Mason270901/vertical-profiling-float/pictures/scope/README.md

1: yellow trace is the 47k + 100nF pulled up signal. green is the esp32's idea of every edge
2: same as 1, but zoomed out
