Mason270901/vertical-profiling-float/datasheets/linear_actuator.jpg

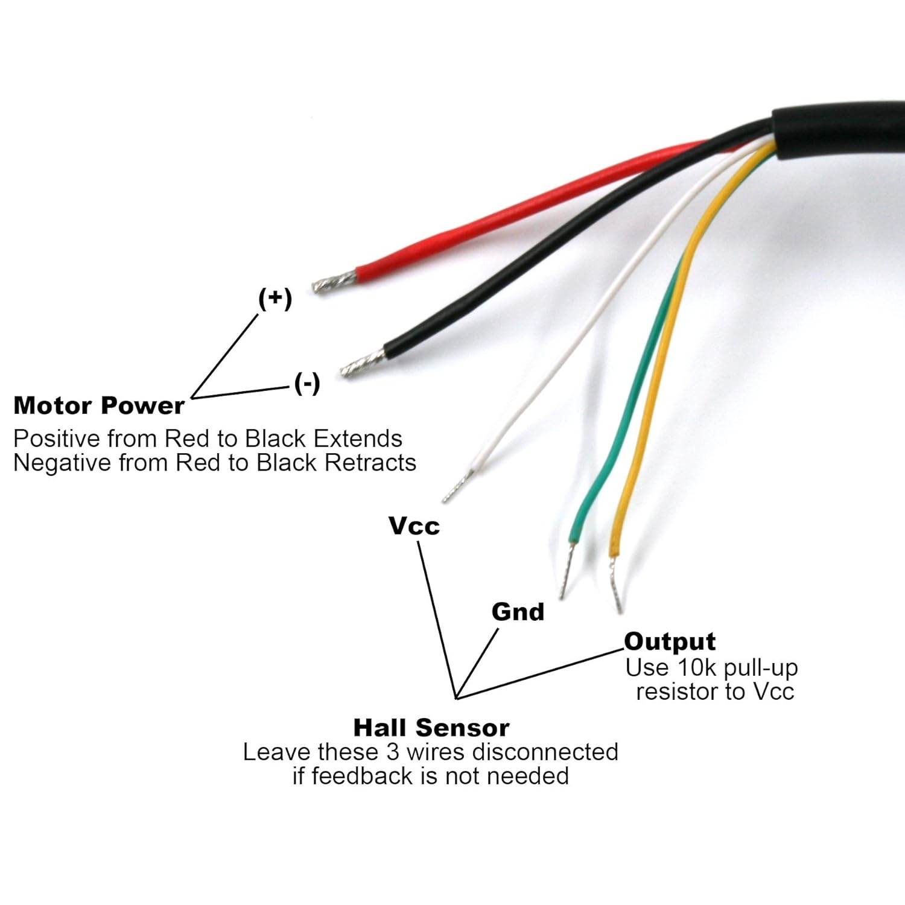
datasheets/linear_actuator.jpg
