Mason270901/vertical-profiling-float/datasheets/linear_actuator_schematic.jpg

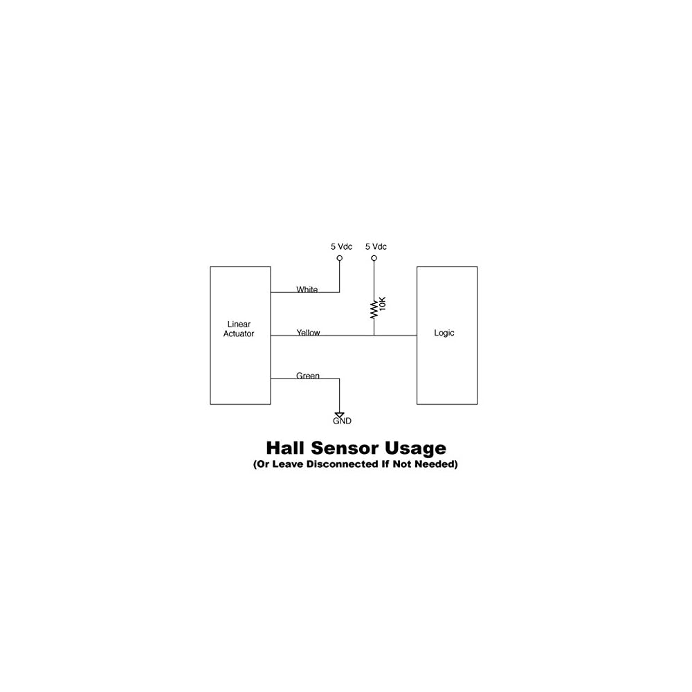
datasheets/linear_actuator_schematic.jpg
