Mason270901/vertical-profiling-float/pictures/scope/scope_1.png

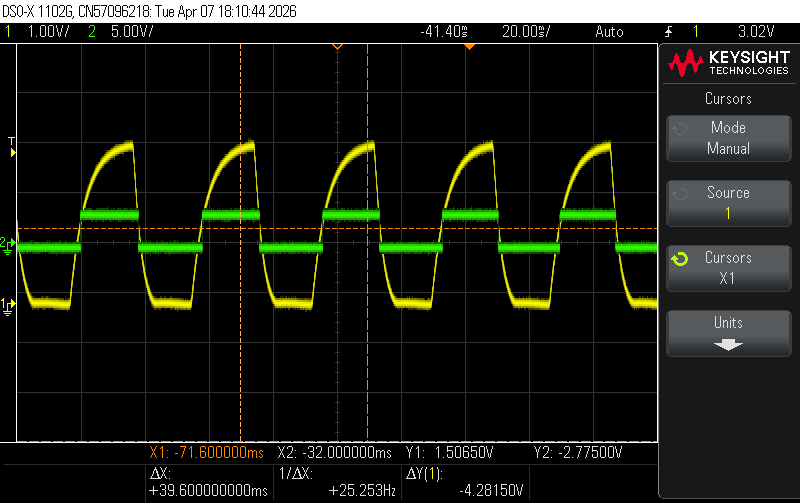
pictures/scope/scope_1.png
