Mason270901/vertical-profiling-float/pictures/scope/scope_2.png

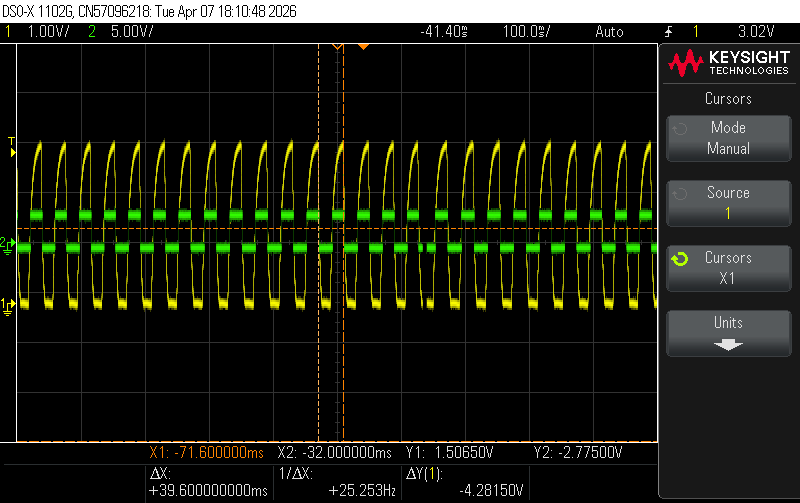
pictures/scope/scope_2.png
