Mason270901/vertical-profiling-float/wireviz/vert.png

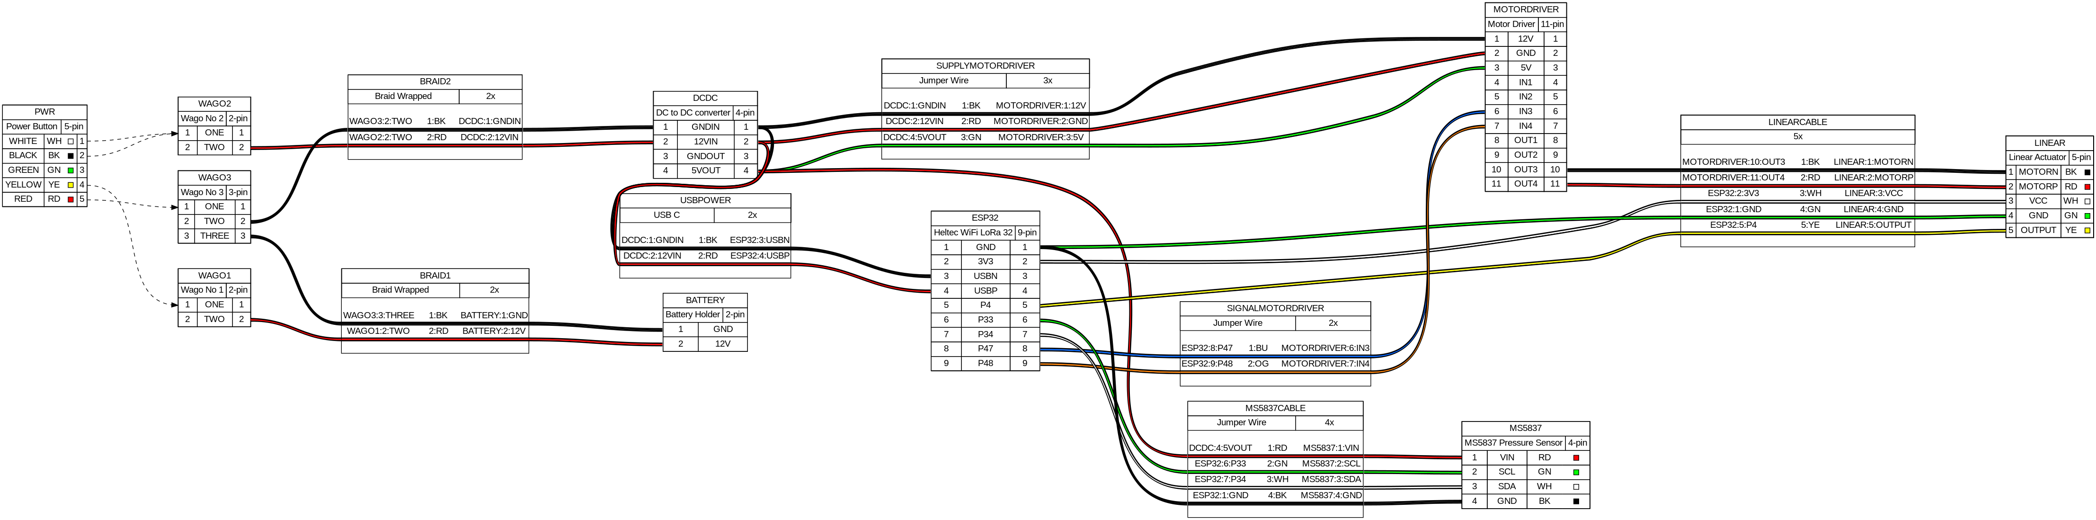
wireviz/vert.png
