Mason270901/vertical-profiling-float/varduino/varduino.ino

/*
  Vertical Profiling Float — web server with AJAX endpoints.
  Files are served from a LittleFS image flashed to the spiffs partition.

  Steps:
  1. Put files in varduino/data/
  2. Run: make fs-flash   (builds and flashes the LittleFS image)
  3. Run: make && make program  (compile and flash the sketch)
  4. Connect to the access point "yourAP"
  5. Browse to http://192.168.4.1/

  AJAX endpoints (return JSON, no redirect):
    GET /H     — turn LED on  → {"led":"on"}
    GET /L     — turn LED off → {"led":"off"}
    GET /data  — [[depth,pressure],...] array → {"data":[[...],...]}
*/

// for wifi
#include <WiFi.h>
#include <WiFiAP.h>
#include <LittleFS.h>
// for pressure
#include <Wire.h>
#include "MS5837.h"
// my lib for syringe
#include "syringe.hpp"

///////////////////////////////////////////////////////////////////////////////
// Pressure Sensor
// Red   - Vin   (5V)
// Green - SCL   (CLOCK)
// White - SDA   (DATA)
// Black - GND
#define CLOCK 33
#define DATA  34

///////////////////////////////////////////////////////////////////////////////
// motor driver board is labeled
// in 1, in 2, in 3, in 4
// nc  , nc  , blue, orange
#define MOTOR_UP   48
#define MOTOR_DOWN 47

///////////////////////////////////////////////////////////////////////////////

#ifndef LED_BUILTIN
#define LED_BUILTIN 2
#endif

///////////////////////////////////////////////////////////////////////////////
// controls and setpoints

// #define USE_FAKE_PRESSURE
// #define SKIP_INITIAL_SYRINGE_LIMITSWITCH
// #define SKIP_PROFILE_FSM
// #define WIFI_LOG_VERBOSE

// how many seconds does it take to home the linear actuator
const int home_seconds = 38;

// how much depth to add to offset (for sea level etc)
const float depth_add = 0.02;

// readings beyond this magnitude (metres) are treated as sensor errors
// they are not logged, and the FSM is not fed this value
// the FSM is fed the last value over and over that is below this threshold
const float max_valid_depth = 100.0f;

///////////////////////////////////////////////////////////////////////////////

// Bar30: MS5837_30BA (up to 300 m depth)
// Bar02: MS5837_02BA (up to 10 m depth)
// Change the model below if you have a Bar02.
// #define SENSOR_MODEL MS5837::MS5837_30BA

#ifndef USE_FAKE_PRESSURE
MS5837 sensor;
#endif


// Runtime FSM enable flag — toggled via /enableFSM and /disableFSM endpoints
static int          fsmEnabled         = 1;
static float        lastValidDepth     = 0.0f;


const char *ssid     = "RN02verticalprofile";
const char *password = "password1!";

WiFiServer server(80);

// ---------------------------------------------------------------------------
// Sensor log: [depth (m), pressure (mbar)] per entry, appended every 4 s
// ---------------------------------------------------------------------------
#define DATA_MAX 300
float    sensorData[DATA_MAX][2];  // [][0]=depth  [][1]=pressure
int      sensorDataLen = 0;

void log_data(const float depth, const float pressure) {
  if (fabsf(depth) > max_valid_depth) return;  // discard implausible depth readings
  if (sensorDataLen < DATA_MAX) {
      sensorData[sensorDataLen][0] = depth;
      sensorData[sensorDataLen][1] = pressure;
      sensorDataLen++;
    }
}

typedef void (*Runnable)(unsigned long);

#define ARRAY_SIZE(arr) (sizeof(arr) / sizeof(arr[0]))

// Return a MIME type string based on file extension
String mimeType(const String &path) {
  if (path.endsWith(".html") || path.endsWith(".htm")) return "text/html";
  if (path.endsWith(".css"))  return "text/css";
  if (path.endsWith(".js"))   return "application/javascript";
  if (path.endsWith(".json")) return "application/json";
  if (path.endsWith(".png"))  return "image/png";
  if (path.endsWith(".jpg") || path.endsWith(".jpeg")) return "image/jpeg";
  if (path.endsWith(".ico"))  return "image/x-icon";
  if (path.endsWith(".svg"))  return "image/svg+xml";
  if (path.endsWith(".txt"))  return "text/plain";
  return "application/octet-stream";
}

// Send a file from LittleFS to the client, returns true on success
bool serveFile(WiFiClient &client, const String &path) {
  String filePath = (path == "/") ? "/index.html" : path;
  if (!LittleFS.exists(filePath)) {
    return false;
  }
  File file = LittleFS.open(filePath, "r");
  if (!file) {
    return false;
  }
  client.println("HTTP/1.1 200 OK");
  client.print("Content-Type: ");
  client.println(mimeType(filePath));
  client.print("Content-Length: ");
  client.println(file.size());
  client.println("Connection: close");
  client.println();
  // Stream file in chunks
  uint8_t buf[512];
  while (file.available()) {
    int len = file.read(buf, sizeof(buf));
    client.write(buf, len);
  }
  file.close();
  return true;
}

// Send a JSON response with CORS headers
void sendJson(WiFiClient &client, int code, const String &body) {
  String status = (code == 200) ? "200 OK" : "404 Not Found";
  client.println("HTTP/1.1 " + status);
  client.println("Content-Type: application/json");
  client.println("Access-Control-Allow-Origin: *");
  client.print("Content-Length: ");
  client.println(body.length());
  client.println("Connection: close");
  client.println();
  client.print(body);
}

void send404(WiFiClient &client) {
  client.println("HTTP/1.1 404 Not Found");
  client.println("Content-Type: text/plain");
  client.println("Connection: close");
  client.println();
  client.println("404 Not Found");
}

#ifndef USE_FAKE_PRESSURE
void setupPressure() {
  Wire.begin(DATA, CLOCK);
  Wire.setClock(10000);

  // sensor.setModel(SENSOR_MODEL);

  int i = 0;

  while (!sensor.init()) {
    Serial.println("MS5837 init failed — check wiring");
    for(int j = 0; j < 50; j++) {
      delay(50);
      digitalWrite(LED_BUILTIN, j%2==0);
    }
    digitalWrite(LED_BUILTIN, HIGH);
  }

  // Freshwater density: 997 kg/m³  Saltwater: 1029 kg/m³
  sensor.setFluidDensity(997);
  // sensor.setFluidDensity(1029);

  Serial.println("MS5837 ready");
}
#endif



void blinkNum(int n) {
  for (int i = 0; i < n; i++) {
    digitalWrite(LED_BUILTIN, HIGH);
    delay(200);
    digitalWrite(LED_BUILTIN, LOW);
    if (i < n - 1) {
      delay(150); // don't delay on final blink
    }
  }
}

void setup() {
  pinMode(LED_BUILTIN, OUTPUT);
  Serial.begin(115200);
  Serial.println();

#ifndef USE_FAKE_PRESSURE
  // setup the pressure sensor
  // needs serial and the LED setup first
  setupPressure();
#endif

  syringeSetup(MOTOR_UP, MOTOR_DOWN);

  // turn LED on
  digitalWrite(LED_BUILTIN, HIGH);

  // record when we are homing the axis
  unsigned long start_home = micros();

#ifndef SKIP_INITIAL_SYRINGE_LIMITSWITCH
  // Empty the syringe at startup so position is known
  waterOut();
#endif


  if (!LittleFS.begin()) {
    Serial.println("LittleFS mount failed — did you run `make program-data` ?");
    while (1);
  }
  Serial.println("LittleFS mounted.");

  Serial.println("Configuring access point...");
  if (!WiFi.softAP(ssid, password)) {
    log_e("Soft AP creation failed.");
    while (1);
  }
  Serial.print("AP IP address: ");
  Serial.println(WiFi.softAPIP());
  server.begin();
  Serial.println("Server started");

#ifndef SKIP_INITIAL_SYRINGE_LIMITSWITCH
  // wait until 38 seconds after homing
  // LED blinks faster and faster to visually track progress of the homing process
  {
    unsigned long total_us    = (unsigned long)home_seconds * 1000000UL;
    unsigned long last_toggle = start_home;
    while ((micros() - start_home) < total_us) {
      unsigned long elapsed   = micros() - start_home;
      unsigned long pct       = elapsed / (total_us / 100UL);  // 0 – 100
      unsigned long period_us = 800000UL - 7200UL * pct;       // 800 ms → 80 ms
      if (micros() - last_toggle >= period_us) {
        digitalWrite(LED_BUILTIN, !digitalRead(LED_BUILTIN));
        last_toggle = micros();
      }
    }
  }

  waterStop();
#endif

  // turn LED off
  digitalWrite(LED_BUILTIN, LOW);

  // Zero all tracking state — syringe is now at a known empty position
  syringeReset();
}

// ---------------------------------------------------------------------------
// Profile state — declared here so wifi_loop can reference it
// ---------------------------------------------------------------------------
enum ProfileState {
  PROFILE_WAITING_PLACE_WATER = 1,
  PROFILE_DIVING,
  PROFILE_STABALIZE,
  PROFILE_CLIMB,
  PROFILE_SURFACE,
  PROFILE_FINISHED
};

static ProfileState profileState = PROFILE_WAITING_PLACE_WATER;

static const char* profileStateStr(int s) {
  switch (s) {
    case PROFILE_WAITING_PLACE_WATER: return "WAITING";
    case PROFILE_DIVING:              return "DIVING";
    case PROFILE_STABALIZE:           return "STABILIZE";
    case PROFILE_CLIMB:               return "CLIMB";
    case PROFILE_SURFACE:             return "SURFACE";
    case PROFILE_FINISHED:            return "FINISHED";
    default:                          return "UNKNOWN";
  }
}

// ---------------------------------------------------------------------------
// wifi_loop — non-blocking Runnable
// ---------------------------------------------------------------------------
#define WIFI_STATE_IDLE    0
#define WIFI_STATE_READING 1

static int        wifiState       = WIFI_STATE_IDLE;
static WiFiClient wifiClient;
static String     wifiRequestLine;
static String     wifiCurrentLine;
static bool       wifiFirstLine;

void wifi_loop(unsigned long now) {
  switch (wifiState) {

  case WIFI_STATE_IDLE: {
    WiFiClient c = server.available();
    if (!c) return;
    wifiClient      = c;
    wifiRequestLine = "";
    wifiCurrentLine = "";
    wifiFirstLine   = true;
    #ifdef WIFI_LOG_VERBOSE
    Serial.println("New Client.");
    #endif
    wifiState = WIFI_STATE_READING;
    break;
  }

  case WIFI_STATE_READING: {
    if (!wifiClient.connected()) {
      wifiClient.stop();
      #ifdef WIFI_LOG_VERBOSE
      Serial.println("Client Disconnected.");
      #endif
      wifiState = WIFI_STATE_IDLE;
      return;
    }
    // Drain only the bytes that are already available — never block.
    while (wifiClient.available()) {
      char c = wifiClient.read();
      if (c == '\n') {
        if (wifiFirstLine) {
          wifiRequestLine = wifiCurrentLine;  // e.g. "GET /index.html HTTP/1.1"
          wifiFirstLine   = false;
        }
        if (wifiCurrentLine.length() == 0) {
          // Blank line = end of headers, dispatch response.

          // Parse path from request line: "GET /path HTTP/1.1"
          String path = "/";
          int pathStart = wifiRequestLine.indexOf(' ');
          int pathEnd   = wifiRequestLine.indexOf(' ', pathStart + 1);
          if (pathStart >= 0 && pathEnd > pathStart) {
            path = wifiRequestLine.substring(pathStart + 1, pathEnd);
          }
          #ifdef WIFI_LOG_VERBOSE
          Serial.print("Request: ");
          Serial.println(path);
          #endif

          // AJAX endpoint: LED on
          if (path == "/H") {
            digitalWrite(LED_BUILTIN, HIGH);
            sendJson(wifiClient, 200, "{\"led\":\"on\"}");

          // AJAX endpoint: LED off
          } else if (path == "/L") {
            digitalWrite(LED_BUILTIN, LOW);
            sendJson(wifiClient, 200, "{\"led\":\"off\"}");

          // AJAX endpoint: enable profile FSM
          } else if (path == "/enableFSM") {
            fsmEnabled = 1;
            sendJson(wifiClient, 200, "{\"fsm\":\"enabled\"}");

          // AJAX endpoint: disable profile FSM
          } else if (path == "/disableFSM") {
            fsmEnabled = 0;
            sendJson(wifiClient, 200, "{\"fsm\":\"disabled\"}");

          // AJAX endpoint: set syringe setpoint  GET /setpoint?v=NNN
          } else if (path.startsWith("/setpoint")) {
            int paramIdx = path.indexOf("v=");
            if (paramIdx >= 0) {
              int val = path.substring(paramIdx + 2).toInt();
              if (val < -40)   val = -40;
              if (val > 290) val = 290; // max is 250, but due to hysteresis this allows to hit both limit switches
              syringeSetpoint(val);
              sendJson(wifiClient, 200, "{\"setpoint\":" + String(val) + "}");
            } else {
              sendJson(wifiClient, 200, "{\"error\":\"missing v param\"}");
            }

          // AJAX endpoint: system status summary
          } else if (path == "/status") {
            char syrJson[72];
            syringeStatusStr(syrJson, sizeof(syrJson));
            String json = "{\"syringe\":";
            json += syrJson;
            json += ",\"fsm\":\"";
            json += fsmEnabled ? "enabled" : "disabled";
            json += "\",\"profile\":\"";
            json += profileStateStr(profileState);
            json += "\",\"depth\":";
            json += String(lastValidDepth, 4);
            json += "}"; 
            sendJson(wifiClient, 200, json);

          // AJAX endpoint: return logged depth/pressure pairs as JSON
          } else if (path == "/data") {
            String json = "{\"data\":[";
            for (int i = 0; i < sensorDataLen; i++) {
              json += "[";
              json += String(sensorData[i][0], 4);
              json += ",";
              json += String(sensorData[i][1], 2);
              json += "]";
              if (i < sensorDataLen - 1) json += ",";
            }
            json += "]}";
            sendJson(wifiClient, 200, json);
          } else {
            if (!serveFile(wifiClient, path)) {
              send404(wifiClient);
            }
          }

          wifiClient.stop();
          #ifdef WIFI_LOG_VERBOSE
          Serial.println("Client Disconnected.");
          #endif
          wifiState = WIFI_STATE_IDLE;
          return;
        }
        wifiCurrentLine = "";
      } else if (c != '\r') {
        wifiCurrentLine += c;
      }
    }
    break;
  }

  }
}

// ---------------------------------------------------------------------------
// led_blink — non-blocking Runnable that toggles the LED every 2 seconds.
// Called at the rate defined by period[]; no internal timing needed.
// ---------------------------------------------------------------------------
static bool ledOn = true;

void led_blink(unsigned long now) {
  ledOn = !ledOn;
  digitalWrite(LED_BUILTIN, ledOn ? HIGH : LOW);
}

// ---------------------------------------------------------------------------
// syringe
// ---------------------------------------------------------------------------

void run_syringe(unsigned long now) {
  syringeLoop();
}

// ---------------------------------------------------------------------------
// Profile FSM
// ---------------------------------------------------------------------------

// (enum ProfileState and profileState global are declared above wifi_loop)

// controls
// initialWaitPoint is the only absolute value; all others are deltas of
// the previous profileSetpoint so that hysteresis is carried forward.
static int          initialWaitPoint       = 0;   // absolute starting setpoint
static int          descendDelta           = +150;   // added to profileSetpoint on DIVING entry
static int          stabilizeEntryDelta    = -20;   // added to profileSetpoint on STABALIZE entry
static int          climbDelta             = -30;   // added to profileSetpoint on CLIMB entry
static int          aggressiveClimbDelta   = -5;    // offset from climbEntrySetpoint in deep CLIMB phase



static int          profileSetpoint    = initialWaitPoint;  // tracks current setpoint; starts == initialWaitPoint
static int          climbEntrySetpoint = 0;     // snapshot of profileSetpoint when CLIMB is entered
static int          stabilizeCount     = 0;
static int          climbCount         = 0;

// Consecutive in-range calls needed for a 31-second window (500 ms / call)
static const int PROFILE_REQUIRED_COUNT = 62;

// Depth thresholds (metres)
static const float DIVE_STABALIZE_DEPTH = 2.1f;   // begin STABALIZE early to avoid overshoot
static const float STAB_TARGET          = 2.5f;
static const float STAB_LOWER           = 2.27f;
static const float STAB_UPPER           = 2.83f;
static const float CLIMB_TARGET         = 0.5f;
static const float CLIMB_HOLD_UPPER     = 0.80f;  // upper bound for "holding at 0.5 m"
static const float SURFACE_THRESH       = 0.10f;  // depth at which we consider surfaced

void profile_fsm_run(float depth) {
  static unsigned long lastBlinkUs = 0;
  unsigned long nowUs = micros();
  if (nowUs - lastBlinkUs >= 2000000UL) {
    blinkNum(profileState);
    lastBlinkUs = nowUs;
  }

  switch (profileState) {

  case PROFILE_WAITING_PLACE_WATER:
    // Keep syringe at a neutral position while waiting to be placed in water.
    syringeSetpoint(profileSetpoint);   // profileSetpoint == initialWaitPoint at start
    if (depth > 0.5f) {
      Serial.println("FSM -> DIVING");
      profileSetpoint += descendDelta;  // e.g. 150 + 10 = 160
      profileState = PROFILE_DIVING;
      blinkNum(profileState);
    }
    break;

  case PROFILE_DIVING:
    // Fill syringe to descend; transition early to avoid overshooting 2.5 m.
    syringeSetpoint(profileSetpoint);
    if (depth >= DIVE_STABALIZE_DEPTH) {
      Serial.println("FSM -> STABALIZE");
      profileSetpoint += stabilizeEntryDelta;  // back off to slow the descent
      stabilizeCount   = 0;
      profileState     = PROFILE_STABALIZE;
      blinkNum(profileState);
    }
    break;

  case PROFILE_STABALIZE: {
    bool inRange = (depth >= STAB_LOWER && depth <= STAB_UPPER);

    if (!inRange) {
      // Out of the acceptable window — reset timer and apply a stronger correction.
      stabilizeCount = 0;
      if (depth > STAB_UPPER) profileSetpoint -= 2;  // too deep: shed water to rise
      else                     profileSetpoint += 2;  // too shallow: take on water to dive
    } else {
      stabilizeCount++;
      // Within range but apply fine corrections to stay centred on STAB_TARGET.
      // Hysteresis/voltage variations mean we must keep adjusting dynamically.
      if      (depth > STAB_TARGET + 0.1f) profileSetpoint--;  // drifting deep
      else if (depth < STAB_TARGET - 0.1f) profileSetpoint++;  // drifting shallow
    }

    syringeSetpoint(profileSetpoint);

    if (stabilizeCount >= PROFILE_REQUIRED_COUNT) {
      Serial.println("FSM -> CLIMB");
      profileSetpoint    += climbDelta;         // delta from whatever actually stabilized
      climbEntrySetpoint  = profileSetpoint;   // snapshot for aggressive-climb phase
      climbCount          = 0;
      profileState        = PROFILE_CLIMB;
      blinkNum(profileState);
    }
    break;
  }

  case PROFILE_CLIMB: {
    // Rise toward 0.5 m; never cross above it (do not surface prematurely).
    if (depth > CLIMB_HOLD_UPPER) {
      // Still well below 0.5 m target, ascend aggressively.
      profileSetpoint = climbEntrySetpoint + aggressiveClimbDelta;
    } else if (depth > CLIMB_TARGET) {
      // Approaching 0.5 m — throttle ascent to avoid overshoot.
      if (depth > CLIMB_TARGET + 0.15f) profileSetpoint--;
      else                               profileSetpoint++;
    } else {
      // depth <= 0.5 m: ascending past target; add water to brake.
      profileSetpoint += 2;
    }

    syringeSetpoint(profileSetpoint);

    // Accumulate time while holding within [0.5 m, 0.8 m].
    if (depth >= CLIMB_TARGET && depth <= CLIMB_HOLD_UPPER) {
      climbCount++;
    } else {
      climbCount = 0;
    }

    if (climbCount >= PROFILE_REQUIRED_COUNT) {
      Serial.println("FSM -> SURFACE");
      profileSetpoint -= 10;
      profileState     = PROFILE_SURFACE;
      blinkNum(profileState);
    }
    break;
  }

  case PROFILE_SURFACE:
    // Progressively decrease setpoint (including negative values if needed)
    // to expel water and ascend to the surface.
    if (depth > SURFACE_THRESH) {
      profileSetpoint -= 3;
      if (profileSetpoint < -50) profileSetpoint = -50;
    } else {
      Serial.println("FSM -> FINISHED");
      profileState = PROFILE_FINISHED;
      blinkNum(profileState);
    }
    syringeSetpoint(profileSetpoint);
    break;

  case PROFILE_FINISHED:
    // Hold here and do nothing.
    break;
  }
}

// ---------------------------------------------------------------------------
// read_pressure — read MS5837 and print to Serial every 500 ms.
// Appends to sensorData[] on every 8th call (≈ every 4 s).
// ---------------------------------------------------------------------------
static int pressureCallCount = 0;

#ifndef USE_FAKE_PRESSURE

void read_pressure(unsigned long now) {
  sensor.read();

  // avoid calling these functions more than once
  float pressure, temperature, depth, altitude;
  pressure = sensor.pressure();
  temperature = sensor.temperature();
  depth = sensor.depth() + depth_add; // add in our manual offset
  altitude = sensor.altitude();


  char buf[120];
  snprintf(buf, sizeof(buf),
    "pressure=%.2f mbar  temp=%.2f C  depth=%.4f m  altitude=%.2f m",
    pressure,
    temperature,
    depth,
    altitude);

  Serial.println(buf);

  if (fabsf(depth) <= max_valid_depth) {
    lastValidDepth = depth;
  }

  if (fsmEnabled) {
    profile_fsm_run(lastValidDepth);
  }

  pressureCallCount++;
  if (pressureCallCount >= 8) {
    pressureCallCount = 0;
    log_data(depth, pressure);
  }
}

#else
// THIS is the fake version
// Ramps depth 0.1 m/call up to 2.5 m (call 24, 0-indexed), holds through call 264.
// Pressure is set equal to depth.
static int fakePressureCallNum = 0;

void read_pressure(unsigned long now) {
  float depth;
  if (fakePressureCallNum < 25) {
    depth = (fakePressureCallNum + 1) * 0.1f;  // call 0 → 0.1 m … call 24 → 2.5 m
  } else {
    depth = 2.5f;                               // hold at 2.5 m
  }
  float pressure = depth;

  char buf[80];
  snprintf(buf, sizeof(buf), "FAKE depth=%.2f m  pressure=%.2f", depth, pressure);
  Serial.println(buf);

  if (fsmEnabled) {
    profile_fsm_run(depth);
  }

  pressureCallCount++;
  if (pressureCallCount >= 8) {
    pressureCallCount = 0;
    log_data(depth, pressure);
  }

  fakePressureCallNum++;
}

#endif



// ---------------------------------------------------------------------------
// Runnable table + main loop
// ---------------------------------------------------------------------------
// Runnable runnables[] = { wifi_loop, led_blink, run_syringe, read_pressure };
Runnable runnables[] = { wifi_loop, run_syringe, read_pressure };

const int num_runnable = ARRAY_SIZE(runnables);

// Last time each Runnable was called
// unsigned long last_run[] = {0, 0, 0, 0};
unsigned long last_run[] = {0, 0, 0};

// Call period in us for each Runnable (0 = every loop iteration)
// unsigned long period[] = {0, 2000000, 1000, 500000};
unsigned long period[] = {0, 1000, 500000};

void loop() {
  const unsigned long now = micros();
  for (int i = 0; i < num_runnable; i++) {
    if (now - last_run[i] >= period[i]) {
      runnables[i](now);
      last_run[i] = now;
    }
  }
}
