Mason270901/vertical-profiling-float/wireviz/vert.yml

connectors:
  PWR:
    type: Power Button
    pinlabels: [WHITE, BLACK, GREEN, YELLOW, RED]
    pincolors: [WH, BK, GN, YE, RD]
  WAGO1:
    type: Wago No 1
    pinlabels: [ONE, TWO]
  WAGO2:
    type: Wago No 2
    pinlabels: [ONE, TWO]
  WAGO3:
    type: Wago No 3
    pinlabels: [ONE, TWO, THREE]
  BATTERY:
    type: Battery Holder
    pinlabels: [GND, 12V]
  DCDC:
    type: DC to DC converter
    pinlabels: [GNDIN, 12VIN, GNDOUT, 5VOUT]
  MOTORDRIVER:
    type: Motor Driver
    pinlabels: [12V, GND, 5V, IN1, IN2, IN3, IN4, OUT1, OUT2, OUT3, OUT4]
  ESP32:
    type: Heltec WiFi LoRa 32
    pinlabels: [GND, 3V3, USBN, USBP, P4, P33, P34, P47, P48]
  LINEAR:
    type: Linear Actuator
    pinlabels: [MOTORN, MOTORP, VCC, GND, OUTPUT]
    pincolors: [BK, RD, WH, GN, YE]
  MS5837:
    type: MS5837 Pressure Sensor
    pinlabels: [VIN, SCL, SDA, GND]
    pincolors: [RD, GN, WH, BK]


# BK ##000000 (black)
# WH ##ffffff (white)
# GY ##999999 (grey)
# PK ##ff66cc (pink)
# RD ##ff0000 (red)
# OG ##ff8000 (orange)
# YE ##ffff00 (yellow)
# OL ##708000 (olive green)
# GN ##00ff00 (green)
# TQ ##00ffff (turquoise)
# LB ##a0dfff (light blue)
# BU ##0066ff (blue)
# VT ##8000ff (violet)
# BN ##895956 (brown)
# BG ##ceb673 (beige)
# IV ##f5f0d0 (ivory)
# SL ##708090 (slate)
# CU ##d6775e (copper)
# SN ##aaaaaa (tin)
# SR ##84878c (silver)
# GD ##ffcf80 (gold)

cables:
  BRAID1:
    wirecount: 2
    colors: [BK, RD]
    type: Braid Wrapped
  BRAID2:
    wirecount: 2
    colors: [BK, RD]
    type: Braid Wrapped
  SUPPLYMOTORDRIVER:
    wirecount: 3
    colors: [BK, RD, GN]
    type: Jumper Wire
  SIGNALMOTORDRIVER:
    wirecount: 2
    colors: [BU, OG]
    type: Jumper Wire
  LINEARCABLE:
    wirecount: 5
    colors: [BK, RD, WH, GN, YE]
  MS5837CABLE:
    wirecount: 4
    colors: [RD, GN, WH, BK]
    type: Jumper Wire
  USBPOWER:
    wirecount: 2
    colors: [BK, RD]
    type: USB C

connections:
  -
    - PWR:   [1, 2]
    - -->
    - WAGO2: [1, 1]
  - 
    - PWR: [5]
    - -->
    - WAGO3: [1]
  - 
    - PWR: [4]
    - -->
    - WAGO1: [1]
  -
    - WAGO3: [2]
    - BRAID2: [1]
    - DCDC: [1]
  -
    - WAGO2: [2]
    - BRAID2: [2]
    - DCDC: [2]
  -
    - WAGO3: [3]
    - BRAID1: [1]
    - BATTERY: [1]
  -
    - WAGO1: [2]
    - BRAID1: [2]
    - BATTERY: [2]
  -
    - DCDC:              [1, 2, 4]
    - SUPPLYMOTORDRIVER: [1, 2, 3]
    - MOTORDRIVER:       [1, 2, 3]
  -
    - ESP32:             [8, 9]
    - SIGNALMOTORDRIVER: [1, 2]
    - MOTORDRIVER:       [6, 7]
  -
    - MOTORDRIVER: [10, 11]
    - LINEARCABLE: [1, 2]
    - LINEAR: [1, 2]
  -
    - ESP32: [5, 2, 1]
    - LINEARCABLE: [5, 3, 4]
    - LINEAR: [5, 3, 4]
  -
    - DCDC: [4]
    - MS5837CABLE: [1]
    - MS5837: [1]
  -
    - ESP32: [6, 7, 1]
    - MS5837CABLE: [2, 3, 4]
    - MS5837: [2, 3, 4]
  -
    - DCDC: [1, 2]
    - USBPOWER: [1, 2]
    - ESP32: [3, 4]

tweak:
  append:
    - "{rank=same; DCDC; USBPOWER}"
    # - "{rank=same; ESP32; MS5837CABLE}"

# tweak:
#   append: "SIGNALMOTORDRIVER -- MS5837CABLE [style=invis weight=10]"
