Mason270901/vertical-profiling-float/(commit log)

2026-04-07 motor driver
2026-04-18 decent first start to wireviz
2026-04-18 minor wire add
2026-04-18 add motor driver
2026-04-18 get braid1 and battery
2026-04-19 copy syringe library from 32c6e7baf91e8fc4c1000cdeb779c8ffafee47cd
2026-04-19 basic integration of syringe, including homing at start
2026-04-19 blink at startup during the homing
2026-04-19 add linear cable
2026-04-19 Add wireviz for now
    [vert.bom.tsv]
2026-04-19 vix: add pressure sensor, add usbpower, fix wrapping / super wide image
    [vert.bom.tsv]
2026-04-21 pressure is added. it just prints right now.
    added distinctive LED blink at the startup if failure:
    short flutter followed by long on period
    [varduino.ino]
2026-04-25 log real pressure data to array
2026-04-25 add fake pressure
2026-04-25 first go at fsm. this uses a lot of static values so it may cause issues
    [varduino.ino]
2026-04-25 fake pressure allows sensor to be unplugged (aka allows 12v off)
